mridley/emuecu/README.md

# emuecu
Emu ECU - An ECU for flightless birds

An ECU for UAV applications
