mridley/emuecu/kicad/emuecu_2.kicad_pcb

## KiCad design kicad/emuecu_2.kicad_pcb (2019-11-29)

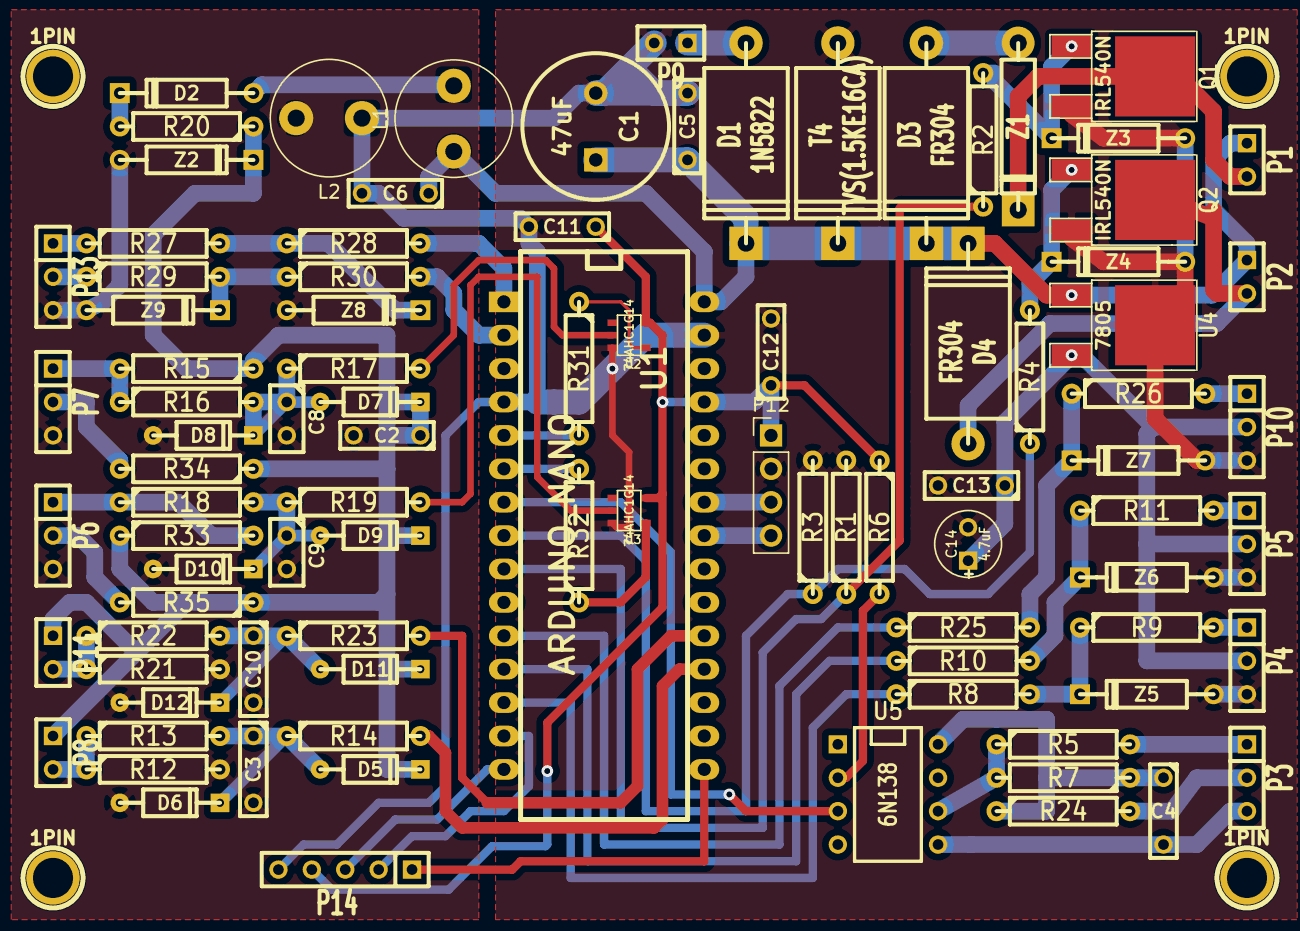
[picture p1: board emuecu_2.kicad_pcb from above]

Board: 2 copper layers, 97 parts (0 on the bottom side), 61 nets.

Parts:
1PIN, 1PIN#2, 1PIN#3, 1PIN#4: P***; 1pin
C1: 47uF; C2V10
C2: 0.1 uF; C2
C3, C4, C5, C6, C10, C11, C12, C13: 0.1uF; C2
C8, C9: 10pF; C1
C14: 4.7uF; C1V5
D1: 1N5822; D6
D2: 1N4002; DO-41
D3, D4: FR304; D6
D5, D6, D7, D8, D9, D10, D11, D12: BAT48; DO-35
L1, L2: 47uH; L_Radial_D8.7mm_P5.00mm_Fastron_07HCP
P1: INJECTOR; SIL-2
P2: FAN/PUMP; SIL-2
P3: IGNITION; SIL-3
P4: LOAD; SIL-3
P5: THROTTLE; SIL-3
P6: SERVO; SIL-3
P7: HALL; SIL-3
P8: ENG TEMP; SIL-2
P9: POWER; SIL-2
P10: PUMP; SIL-3
P11: AIR TEMP; SIL-2
P12: I2C; PinHeader_1x04_P2.54mm_Vertical
P13: Serial; SIL-3
P14: SPI; SIL-5
Q1, Q2: IRL540N; DPAK2
R1, R3: 47k; R4
R2, R4, R14, R17, R19, R23, R30: 1k; R4
R5: 200; R4
R6: 330; R4
R7: 2.2k; R4
R8, R10, R25, R28, R31, R32: 180; R4
R9, R11, R26, R27: 470; R4
R12, R21: 22k; R4
R13, R15, R16, R18, R22, R29, R33: 10k; R4
R20: 240; R4
R24: 220; R4
R34, R35: 100; R4
T4: TVS(1.5KE16CA); D6
U1: ARDUINO_NANO; arduino_nano
U2, U3: 74AHC1G14; SOT23-5
U4: 7805; DPAK2
U5: 6N138; DIP-8__300
Z1: 1N5365B; D5
Z2: IN5919BG (5.6V); DO-41
Z3, Z4, Z5, Z6, Z7, Z8, Z9: 1N4733; DO-41

Connections:
+5C: C2.1, D5.2, D7.2, D9.2, D11.2, P8.1, P11.1, R15.1, R20.1, R33.1, R34.1, R35.1, Z2.2
+5V: C11.1, C12.1, P12.1, P14.4, R6.1, U1.27, U2.5, U3.5
+12V: C1.1, C5.1, C6.1, D1.2, D3.2, D4.2, L1.1, P1.1, P2.1, T4.2, U1.30, U4.1
GND: C1.2, C5.2, C6.2, C11.2, C12.2, C13.2, C14.2, L2.1, P4.3, P5.3, P9.2, P10.3, P12.2, P14.5, Q1.3, Q2.3, R1.2, R3.2, T4.1, U1.4, U1.29, U2.3, U3.3, U4.2, Z3.1, Z4.1, Z5.1, Z6.1, Z7.1
unnamed: C3.1, D5.1, D6.2, R13.2, R14.1
unnamed: C4.1, R7.1, R24.1, U5.8
unnamed: C4.2, P3.3, U5.5
unnamed: C8.1, D7.1, D8.2, R16.2, R17.1
unnamed: C9.1, D9.1, D10.2, R18.2, R19.1
unnamed: C10.1, D11.1, D12.2, R22.2, R23.1
unnamed: C13.1, C14.1, P4.2, P5.2, P10.2, U4.3
unnamed: D1.1, P9.1
unnamed: D2.1, L1.2
unnamed: D2.2, R20.2
unnamed: D3.1, Z1.1
unnamed: D4.1, P2.2, Q2.2
unnamed: P1.2, Q1.2, Z1.2
unnamed: P3.1, R5.2
unnamed: P3.2, R24.2
unnamed: P4.1, R9.2
unnamed: P5.1, R11.2
unnamed: P6.1, R18.1, R33.2
unnamed: P6.2, R35.2
unnamed: P7.1, R15.2, R16.1
unnamed: P7.2, R34.2
unnamed: P8.2, R12.1, R13.1
unnamed: P10.1, R26.2
unnamed: P11.2, R21.1, R22.1
unnamed: P12.3, U1.24
unnamed: P12.4, U1.23
unnamed: P13.1, R27.1
unnamed: P13.2, R29.1
unnamed: P14.1, U1.16
unnamed: P14.2, U1.14
unnamed: P14.3, U1.15
unnamed: Q1.1, R2.2, Z3.2
unnamed: Q2.1, R4.2, Z4.2
unnamed: R1.1, R2.1, U1.9
unnamed: R3.1, R4.1, U1.8
unnamed: R5.1, R7.2, U5.6
unnamed: R6.2, U5.2
unnamed: R8.1, U1.13
unnamed: R8.2, R9.1, Z5.2
unnamed: R10.1, U1.12
unnamed: R10.2, R11.1, Z6.2
unnamed: R14.2, U1.19
unnamed: R17.2, U2.2
unnamed: R19.2, U3.2
unnamed: R23.2, U1.20
unnamed: R25.1, U1.11
unnamed: R25.2, R26.1, Z7.2
unnamed: R27.2, R28.1, Z8.2
unnamed: R28.2, U1.1
unnamed: R29.2, R30.1, Z9.2
unnamed: R30.2, U1.2
unnamed: R31.1, U2.4
unnamed: R31.2, U1.5
unnamed: R32.1, U3.4
unnamed: R32.2, U1.6
unnamed: U1.7, U5.3
SGND: C2.2, C3.2, C8.2, C9.2, C10.2, D6.1, D8.1, D10.1, D12.1, L2.2, P6.3, P7.3, P13.3, R12.2, R21.2, Z2.1, Z8.1, Z9.1
