mridley/emuecu/src/ecu.c

#include "config.h"

#include <avr/io.h>
#include <avr/interrupt.h>
#include <avr/sleep.h>
#include <util/delay.h>
#include <stdio.h>
#include <string.h>
#include <stdlib.h>

#include "config.h"
#include "ecu.h"
#include "uart.h"
#include "timers.h"
#include "inputs.h"
#include "injection.h"
#include "bme280.h"
#include "max6675.h"
#include "log.h"

// default period for telemetry, milliseconds
static uint16_t telem_period_ms = 200U;

#define CLAMP(v, min, max)\
  v = (v > max) ? max : ((v < min) ? min : v );

inline uint16_t clamp_pwm(int16_t v, uint16_t pwm_min, uint16_t pwm_max)
{
  // for no input scenario
  if (v > PWM_LIMIT)
  {
    v = 0U;
  }
  CLAMP(v, pwm_min, pwm_max);
  return v;
}

emustatus_t status = {0};

void engine_crank(bool crank)
{
  if (crank)
  {
    status.pwm1_out = config.pwm1_max;
    set_pwm(1, status.pwm1_out);
  }
  else
  {
    status.pwm1_out = config.pwm1_min;
    set_pwm(1, status.pwm1_out);
  }
}

void engine_stop()
{
  status.starts = 0;
  status.engine_stop_ms = ticks_ms();
  ignition_disable();
  pump_disable();
  engine_crank(false);
}

float throttle(uint16_t run_time_ms)
{
  float throttle_start = (float)(config.thr_start - config.thr_min)/(float)(config.thr_max-config.thr_min);
  if (CRANK == status.state || START == status.state) {
    return throttle_start;
  } else if ((RUNNING == status.state) &&
             (run_time_ms > config.dwell_time_ms) &&
             (run_time_ms < 2*config.dwell_time_ms)) {
    float wgt = (float)(run_time_ms - config.dwell_time_ms)/(float)config.dwell_time_ms;
    return wgt * status.throttle_in + (1.0 - wgt) * throttle_start;
  } else {
    return status.throttle_in;
  }
}

void default_state()
{
  status.state = INIT;
  status.baro = BARO_MSLP_PA;
  status.pwm0_out = config.pwm0_min;
  status.pwm1_out = config.pwm1_min;
  status.throttle_override = 0;
}

/*
  change display period
 */
static void command_period(const char *arg)
{
    uint16_t new_period = strtoul(arg, NULL, 10);
    if (new_period < 50 || new_period > 5000) {
        logmsgf("Invalid period %u", new_period);
    } else {
        telem_period_ms = new_period;
        logmsgf("new period %u", new_period);
    }
}

/*
  process one line of input
 */
static void process_line(char *line)
{
    const char *delim = " {:}";
    char *cmd = strtok(line, delim);
    if (!cmd) {
        return;
    }
    if (strcmp(cmd, "config") == 0) {
        char *arg = strtok(NULL, delim);
        if (arg) {
            if (strcmp(arg, "defaults") == 0) {
                config_defaults();
                logmsgf("config reset to defaults");
            } else if (strcmp(arg, "save") == 0) {
                config_save();
                logmsgf("config saved");
            }
        } else {
            // show config
            config_dump();
        }
    } else if (strcmp(cmd, "period") == 0) {
        char *arg = strtok(NULL, delim);
        if (arg) {
            command_period(arg);
        }
    } else if (strcmp(cmd, "get") == 0) {
        char *arg = strtok(NULL, delim);
        if (arg) {
            config_show(arg);
        }
    } else if (strcmp(cmd, "set") == 0) {
        char *arg1 = strtok(NULL, delim);
        char *arg2 = strtok(NULL, delim);
        if (arg1 && arg2) {
            config_set(arg1, arg2);
        }
    }
}

/*
  check for command input
 */
static void check_input(void)
{
    static char linebuf[32];
    static uint8_t linelen;
    int c;
    while ((c = getchar()) != EOF) {
        if (c == '\r' || c == '\n') {
            c = 0;
        }
        linebuf[linelen++] = c;
        if (c == 0) {
            if (linelen > 1) {
                process_line(linebuf);
            }
            linelen = 0;
        }
        if (linelen == sizeof(linebuf)) {
            linelen = 0;
        }
    }
}

static uint16_t get_throttle_in()
{
    uint16_t ret = 0;
    if (config.thr_src == THROTTLE_SOURCE_JSON) {
        uint16_t now = ticks_ms();
        if (now - status.throttle_set_ms > 1000) {
            // no throttle for 1s, disable
            status.throttle_override = 0;
            status.throttle_set_ms = 0;
        }
        ret = status.throttle_override;
    } else {
        ret = pwm_input();
    }
    if (ret < 1000 && status.state != INIT) {
        status.state = INIT;
        engine_stop();
        logmsgf("engine re-init");
    }
    return ret;
}

/*
  return true if throttle input is at a level that is requesting motor
  start
*/
static bool throttle_should_start()
{
    if (config.thr_src == THROTTLE_SOURCE_JSON) {
        // we don't use THR_START as threshold when using JSON
        // throttle
        return status.thr_in > 1000;
    } else if (config.thr_src == THROTTLE_SOURCE_PWM) {
        return status.thr_in > config.thr_start;
    }
    return false;
}

/*
  return true if throttle input is at a level that we should come out of init
  and go into PRIME
*/
static bool throttle_should_prime()
{
    if (config.thr_src == THROTTLE_SOURCE_JSON) {
        return status.thr_in > 0;
    } else if (config.thr_src == THROTTLE_SOURCE_PWM) {
        return status.thr_in > 0 && status.thr_in < config.thr_start;
    }
    return false;
}

int main(void)
{
  sei(); // Enable Global Interrupt
  uart0_init();
  logmsgf("EMU ECU");

  if (!config_load()) {
    config_defaults();
    config_save();
  }
  config_dump();

  default_state();
  setup_timers(status.pwm0_out, status.pwm1_out);
  setup_inputs();

  bme_read_calib_data();
  bme_start_conversion();
  start_adc();
  sleep(10);

  uint16_t ms = ticks_ms();
  status.engine_stop_ms = ms;
  status.engine_start_ms = ms;
  uint16_t loop_ms = ms - 1000;
  while (1)
  {
    ms = ticks_ms();
    // keep the start/stop times sliding to prevent wraps
    if ((ms - status.engine_stop_ms) > INT16_MAX)
    {
      status.engine_stop_ms = ms - INT16_MAX;
    }
    if ((ms - status.engine_start_ms) > INT16_MAX)
    {
      status.engine_start_ms = ms - INT16_MAX;
    }
    uint16_t run_time_ms = 0U;
    if (RUNNING == status.state || START == status.state || CRANK == status.state) {
      run_time_ms = (ms - status.engine_start_ms);
    }
    status.rpm = rpm();
    status.thr_in = get_throttle_in();
    uint16_t thr_clamped = clamp_pwm((int16_t)status.thr_in, config.thr_min, config.thr_max);
    const float t_scale = 1.0f / (float)(config.thr_max - config.thr_min);
    status.throttle_in = (float)(thr_clamped - config.thr_min) * t_scale;
    status.throttle_out = throttle(run_time_ms);

    int16_t pwm0_out = (int16_t)config.pwm0_min + (int16_t)(status.throttle_out*((int16_t)config.pwm0_max-(int16_t)config.pwm0_min));
    if (config.pwm0_min < config.pwm0_max) {
      status.pwm0_out = clamp_pwm(pwm0_out, config.pwm0_min, config.pwm0_max);
    } else {
      status.pwm0_out = clamp_pwm(pwm0_out, config.pwm0_max, config.pwm0_min);
    }
    set_pwm(0, status.pwm0_out);

    status.pt_c = inj_corrections(status.baro, status.iat, status.cht, run_time_ms);

    inj_map_update_row(status.throttle_out, status.pt_c);
    status.inj_ticks = inj_ticks_(status.rpm);

    check_input();

    // lower frequency tasks
    if ((ms - loop_ms) >= telem_period_ms)
    {
      loop_ms += telem_period_ms;

      status.cht = interp_a_tab(config.a0cal, analogue(0));
      status.iat = interp_a_tab(config.a1cal, analogue(1));

      if (0 == bme_read_data()) {
        status.baro = bme_baro();
        status.ecut = bme_temp();
        status.humidity = bme_humidity();
      }

      int32_t tval = max6675_read();
      if (tval >= 0) {
        status.egt = tval;
      } else {
        logmsgf("max6675 error: %d", tval);
      }

      printf("{\"status\":{\"thr_in\":%d,\"throttle_in\":%d,\"throttle_out\":%d,\"rpm\":%u,\"cht\":%d,\"iat\":%d}}\n",
             status.thr_in, (int)(100*status.throttle_in), (int)(100*status.throttle_out), status.rpm,
             status.cht, status.iat);
      printf("{\"status\":{\"baro\":%lu,\"ecut\":%d,\"humidity\":%u,\"egt\":%lu}}\n",
             status.baro, status.ecut, status.humidity, status.egt);
      printf("{\"status\":{\"pt_c\":%f,\"starts\":%u}}\n",
             status.pt_c, status.starts);
      printf("{\"status\":{\"pwm0_out\":%d,\"pwm1_out\":%d,\"inj_ticks\":%u}}\n",
             status.pwm0_out, status.pwm1_out, status.inj_ticks);

      // start next conversion
      bme_start_conversion();
      start_adc();

      //int c = getchar();
      //logmsgf("c=%d", c);
    }
    switch (status.state)
    {
    case INIT:
      if ((status.pt_c > 0.0) &&
          throttle_should_prime()) {
        status.engine_prime_ms = ticks_ms();
        pump_enable();
        logmsgf("engine prime");
        status.state = PRIME;
      }
      break;
    case PRIME:
      if ((ms - status.engine_prime_ms) > 1000) {
        engine_stop();
        logmsgf("engine stopped");
        status.state = STOPPED;
      }
      break;
    case STOPPED:
      if ((ms - status.engine_stop_ms) > config.dwell_time_ms) {
        if (config.auto_start && !throttle_should_start()) {
          status.starts = 0;
        }
        if ((status.rpm > 0) &&
            (0.0f < status.throttle_in)) {
          status.engine_start_ms = ticks_ms();
          ignition_enable();
          pump_enable();
          logmsgf("engine start");
          status.state = START;
        } else if (config.auto_start &&
                   throttle_should_start() &&
                   (status.starts < config.auto_start)) {
          status.starts++;
          status.engine_start_ms = ticks_ms();
          engine_crank(true);
          pump_enable();
          logmsgf("engine crank");
          status.state = CRANK;
        }
      }
      break;
    case CRANK:
      if (run_time_ms > config.start_time_ms) {
        engine_stop();
        logmsgf("crank failure - engine stopped");
        status.state = STOPPED;
      } else if (status.rpm > 0) {
        ignition_enable();
        logmsgf("engine start");
        status.state = START;
      }
      break;
    case START:
      if (config.auto_start &&
          (status.pwm1_out == config.pwm1_max) &&
          (run_time_ms > config.start_time_ms)) {
        engine_crank(false);
        logmsgf("cranked");
      }
      if ((status.rpm > 0) &&
          (run_time_ms > config.dwell_time_ms)) {
        status.starts = 0;
        logmsgf("engine running");
        status.state = RUNNING;
      }
      // fall through
    case RUNNING:
      if (status.rpm > config.rpm_limit) {
        engine_stop();
        logmsgf("overrev - engine stopped");
        status.state = STOPPED;
      } else if (status.throttle_in <= 0.0f ) {
        engine_stop();
        logmsgf("throttle - engine stopped");
        status.state = STOPPED;
      } else if (!status.rpm) {
        engine_stop();
        logmsgf("engine stopped");
        status.state = STOPPED;
      }
      break;
    default:
      break;
    }
  }
}
