mridley/emuecu/src/py/atab.py

dd0 = [
[48 , 0   ],
[94 , 850 ],
[102, 1200],
[175, 2225],
[171, 2275],
[257, 3450],
[311, 4175],
[414, 5000],
[472, 5500],
[503, 6000],
[522, 6000],
[601, 6750],
[573, 7000],
[623, 7000],
[694, 7675],
[718, 8000],
[805, 9000]
]
dd1 = [
[223  ,0   ],
[366  ,850 ],
[396  ,1200],
[551  ,2225],
[545  ,2275],
[689  ,3450],
[757  ,4175],
[859  ,5000],
[899  ,5500],
[930  ,6000],
[932  ,6000],
[978  ,6750],
[978  ,7000],
[989  ,7000],
[1022 ,7675],
[1023 ,8000],
]

import numpy as np
import pylab as pl

if __name__ == "__main__":
  pl.clf()
  
  d0 = np.array(dd0)
  d1 = np.array(dd1)
  x = np.arange(0,1025,64) 
  p0 = np.polyfit(d0[:,0], d0[:,1], 3)
  p1 = np.polyfit(d1[:,0], d1[:,1], 3)
  v0 = np.polyval(p0,x)
  v1 = np.polyval(p1,x)
  pl.plot(d0[:,0],d0[:,1],'r.')
  pl.plot(d1[:,0],d1[:,1],'r.')
  pl.plot(x,v0,'b')
  pl.plot(x,v1,'g')
  print "atab0 =",v0.astype(int),";"
  print "atab1 =",v1.astype(int),";"
  pl.show()
  
