mridley/emuecu/src/rpm.c

#include "rpm.h"

#include <avr/pgmspace.h>

// usecs to rpm
// ticks = arange(1696, 100000, 32)

static uint32_t rpm_tab_ticks0_ = 1696;

static const uint16_t rpm_tab_[3072] PROGMEM =
{
  35377,
  34722,
  34090,
  33482,
  32894,
  32327,
  31779,
  31250,
  30737,
  30241,
  29761,
  29296,
  28846,
  28409,
  27985,
  27573,
  27173,
  26785,
  26408,
  26041,
  25684,
  25337,
  25000,
  24671,
  24350,
  24038,
  23734,
  23437,
  23148,
  22865,
  22590,
  22321,
  22058,
  21802,
  21551,
  21306,
  21067,
  20833,
  20604,
  20380,
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
};

uint16_t rpm_from_us(uint32_t ticks_us)
{
  if (ticks_us < rpm_tab_ticks0_)
  {
    ticks_us = rpm_tab_ticks0_;
  }
  if (ticks_us >= CRANK_TIMEOUT_USECS)
  {
    return 0;
  }
  ticks_us -= rpm_tab_ticks0_;

  return pgm_read_word( &(rpm_tab_[ticks_us >> 5]) );
}
