mridley/emuecu/(commit log)

2015-08-28 Adding pin allocation doc
2015-08-28 Add schematics
    [emuecu.sch]
2015-10-31 second iteration
    [emuecu_2.sch]
2015-10-31 breaking it down. modify timers.
    [emuecu_2.sch]
2015-11-02 fixing bugs in timer0 overflow and analogue input
    [ecu.c, inputs.c, inputs.h, timers.c, timers.h]
2015-11-03 Fixing some port config bugs
    [inputs.c, timers.c]
2015-11-06 Fixing up pwm input. reorganise some inputs to use OC0x for mosfet outputs.
    [emuecu_2.sch]
2015-11-22 updates to schematic/pcb
    [emuecu.sch, emuecu_2.kicad_pcb, emuecu_2.sch]
2016-01-07 updates to schematic, minor changes to map
    [emuecu_2.kicad_pcb, emuecu_2.sch]
2018-10-04 bme280 support. update resistors for thermister in schematic.
    [emuecu_2.sch]
2018-10-18 bigger map, compute default map, fix humidity
    [bme280.c, config.c, config.h, ecu.c, injection.c, injection.h]
2018-10-20 status and analogue temp calibration tables
2018-10-24 uart interrupts
2018-10-27 fix json output. add pytuner.py for basic monitoring.
    [atab.py, config.c, ecu.c, ecu.h, injection.c, pytuner.py]
2019-10-28 added: kill on zero throttle. added: basic cht temp and crank enrichment. small amount of fudge
2019-11-01 refactor and log max 6675 errors
    [ecu.c, ecu.h, max6675.c, max6675.h]
2019-11-10 fix bug in over temp enrichment. Added Start throttle control
    [config.c, ecu.c, injection.c, injection.h, pytuner.py]
2019-11-24 switch to 5Hz telemetry
2019-11-29 update to kicad 5.1
    [emuecu_2.kicad_pcb, emuecu_2.sch]
2019-12-08 support reverse servo
2019-12-15 added thr_over settable value
    allows for software throttle from flight controller
2019-12-15 fix inj_ticks status, wasn't being updated and now uint16_t
    [ecu.c, ecu.h]
2019-12-15 fix backwards DO-35 after kicad upgrade
    [emuecu_2.sch]
2019-12-27 throttle arming and fixes to default map
    [ecu.c, injection.c, injection.h]
2019-12-28 added software throttle support
