mridley/emuecu/(notices)

Notices in the files:
kicad/attic/emuecu.sch:
This work is licensed under a Creative Commons
Attribution-ShareAlike 4.0 International License.
http://creativecommons.org/licenses/by-sa/4.0
